Krishnawa/WLED_HW/README.md

# WLED_HW
a WLED based ESP12F Hardware
You can find more information about WLED here: https://github.com/Aircoookie/WLED

## Hardware photo
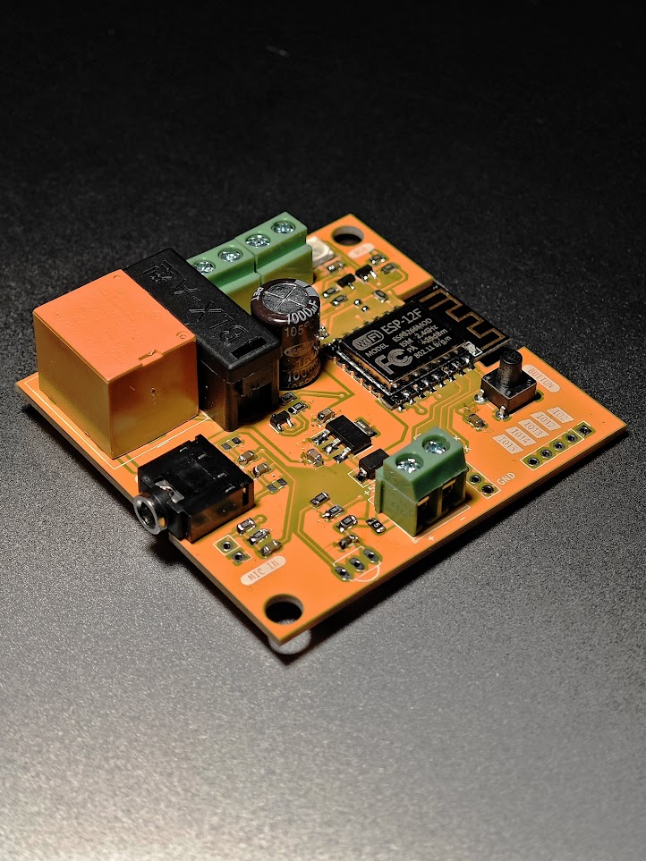
[picture p1: WLED_PROTOTYPE_V0.1/PHOTOS/Board.jpeg]
WLED Hardware
