Krishnawa/WLED_HW/WLED_PROTOTYPE_V0.1/PHOTOS/WLED_V0.1_panelized.png

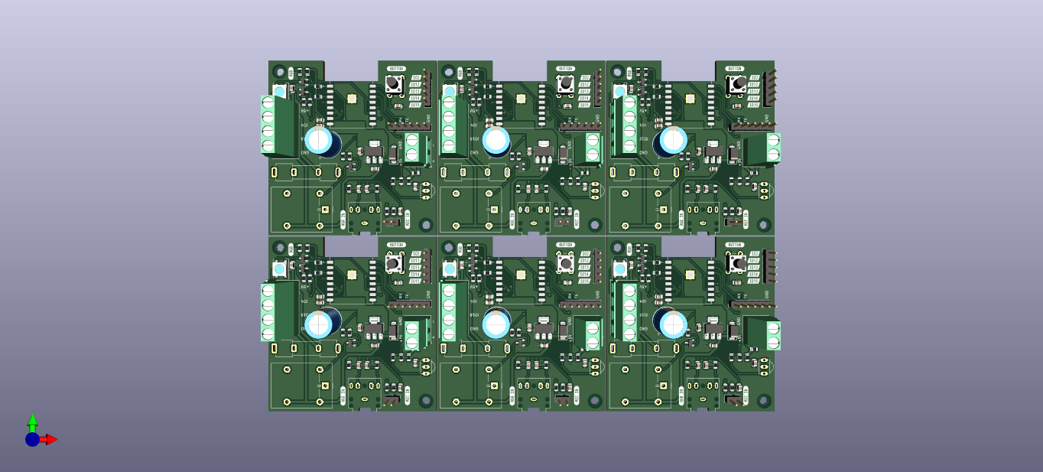
WLED_PROTOTYPE_V0.1/PHOTOS/WLED_V0.1_panelized.png
