Krishnawa/WLED_HW/WLED_PROTOTYPE_V0.1/BOM/WLED_V0.1.xlsx

# | Reference | Qty | Value | DESCRIPTION | SUNROM SKU | UNIT PRICE | PRICE | LINK
1 | C1, C2, C4 | 3 | 10u | 10uF 106 0805 (2012 metric) 50V X7R MLCC SMD | 3913 | 1.5 | 4.5 | https://www.sunrom.com/p/10uf-106-0805-2012-metric-50v-x7r-mlcc-smd
2 | C3, C6, C7, C8, C9, C10 | 6 | 100n | 100nF 104 0805 (2012 metric) 50V X7R MLCC | 3942 | 1.3 | 7.8 | https://www.sunrom.com/p/100nf-104-0805-2012-metric-50v-x7r-mlcc
3 | C5 | 1 | 1000u | 1000uF 16V 10mm Samwha | 6984 | 9 | 9 | https://www.sunrom.com/p/1000uf-16v-10mm-samwha
4 | C11 | 1 | 4.7uF | 4.7uF 475 0603 (1608 metric) 50V X7R MLCC SMD | 6798 | 1.2 | 1.2 | https://www.sunrom.com/p/47uf-475-0603-1608-metric-50v-x7r-mlcc-smd
5 | D1 | 1 | SS16 | SS16 SMA Schottky Diode | 5920 | 1.45 | 1.45 | https://www.sunrom.com/m/5920
6 | D2 | 1 | WS2812B | WS2812B Smart RGB LED | 4366 | 23.6 | 23.6 | https://www.sunrom.com/p/smart-rgb-led
7 | F1 | 1 | Fuse | 0805 PPTC Bourns Part# MF-PSMF050X-2 0.5A 6V 500MA | 4517 | 11.25 | 11.25 | https://www.sunrom.com/p/500ma-pptc-resettable-fuses
8 | F2 | 1 | Fuse | PCB Mount Fuse Holder for 5x20mm Fuses | 4940 | 11.8 | 11.8 | https://www.sunrom.com/p/pcb-mount-fuse-holder-for-5x20mm-fuses
11 | J3 | 2 | Screw_Terminal_01x04 | 2P 5mm 10A Screw Terminal Light | 3883 | 16.5 | 33 | https://www.sunrom.com/p/2p-5mm-10a-screw-terminal-light
12 | J4 | 1 | Screw_Terminal_01x02 | 2P 5mm 10A Screw Terminal Light | 3883 | 8.25 | 8.25 | https://www.sunrom.com/p/2p-5mm-10a-screw-terminal-light
14 | J6 | 1 | AudioJack2_Ground_Switch | Stereo Socket - PCB Mount – 3.5mm | 3986 | 10.03 | 10.03 | https://www.sunrom.com/p/stereo-socket
15 | K1 | 1 | G5LE-1 | Relay 5V - PCB Mount | 3871 | 28 | 28 | https://www.sunrom.com/p/relay-5v-pcb-mount
17 | Q1, Q2, Q3 | 3 | BSS138 | BSS138 SOT23 - MOSFET - N-Channel Hottech | 5592 | 4.75 | 14.25 | https://www.sunrom.com/m/5592
18 | R1, R3, R4, R7, R8, R9, R10, R11, R13,R5, R6 | 11 | 10K | 10K 1% 0805 | 4068 | 0.4 | 4.4 | https://www.sunrom.com/p/10k-1-0805-pack-of-100
19 | R2 | 1 | 10K | 10K 1% 0805 | 4068 |  | 0
21 | R12, R14 | 2 | 3.3K | 3K3 1% 0805 | 4276 | 0.4 | 0.8 | https://www.sunrom.com/p/3k3-1-0805
22 | R15 | 1 | 100 | 100R 1% 0805 | 4505 | 0.4 | 0.4 | https://www.sunrom.com/p/100r-1-0805
23 | SW2 | 1 | SW_SPST | Tactile Switch 6x6x8mm | 5828 | 3.54 | 3.54 | https://www.sunrom.com/p/tactile-switch-6x6x8mm
24 | U1 | 1 | ESP-12S | WiFi Module - ESP8266 - ESP-12F 4MB | 6182 | 255 | 255 | https://www.sunrom.com/p/wifi-module---esp8266---esp-12f-4mb
25 | U2 | 1 | NCP1117-3.3_SOT223 | 1117-3V3 3.3V 1A SOT223 Low Drop Linear Voltage Regulator | 4004 | 9.25 | 9.25 | https://www.sunrom.com/p/1117-3v3-33v-1a-sot223-low-drop-linear-voltage-regulator
26 | U3 | 1 | TSOP1838 | TSOP1838:TSOP18XX | 4471 | 16 | 16 | https://www.sunrom.com/m/4471
 |  |  |  |  |  | TOTAL PRICE | 453.52 | RS
