Krishnawa/WLED_HW/WLED_PROTOTYPE_V0.1/Excel/All Sspec.xlsx

Sheet: Product spec
Product specifications
Power supply | 5V
 | TYPE C USB
Current consumption | Without LED Max 550mA
 | https://wled-calculator.github.io/
Connnectivity | Wi-Fi
Audio | Mic
 | Aux
Indicator | On board LED
Supported LEDs

Sheet: Controller Spec
Column1 | Column2
Module Model | ESP-12S
Package | SMD16
Size | 24*16*3(±0.2)mm
Certification | FCC/CE
SPI Flash | Default 32Mbit
Interface | UART/GPIO/ADC/PWM
IO Port | 9
UART Baud rate | Support 300 ~ 4608000 bps ，Default 115200 bps
Frequency Range | 2412 ~ 2484MHz
Antenna | PCB Antenna
Transmit Power | 802.11b: 16±2 dBm (@11Mbps) 802.11g: 14±2 dBm (@54Mbps) 802.11n: 13±2 dBm (@HT20, MCS7)
Receiving Sensitivity | CCK, 1 Mbps : -90dBm CCK, 11 Mbps: -85dBm 6 Mbps (1/2 BPSK): -88dBm 54 Mbps (3/4 64-QAM): -70dBm HT20, MCS7 (65 Mbps, 72.2 Mbps): -67dBm
Power (Typical Values) | Continuous Transmission=>Average：~71mA，Peak： 500mA Modem Sleep: ~20mA Light Sleep: ~2mA Deep Sleep: ~0.02mA
Security | WEP/WPA-PSK/WPA2-PSK
Power Supply | Voltage 3.0V ~ 3.6V，Typical 3.3V，Current >500mA
Operating Temperature | -20 ℃ ~ 85 ℃
Storage Environment | -40 ℃ ~ 85 ℃ , < 90%RH

Sheet: Pinout
No. | Pin Name | Functional Description
1 | RST | Reset Pin, Active Low
2 | ADC | AD conversion, Input voltage range 0~1V, the value range is 0~1024.
3 | EN | Chip Enabled Pin, Active High
4 | IO16 | Connect with RST pin to wake up Deep Sleep
5 | IO14 | GPIO14; HSPI_CLK
6 | IO12 | GPIO12; HSPI_MISO
7 | IO13 | GPIO13; HSPI_MOSI; UART0_CTS
8 | VCC | Module power supply pin, Voltage 3.0V ~ 3.6V
9 | GND | GND
10 | IO15 | GPIO15; MTDO; HSPICS; UART0_RTS
11 | IO2 | GPIO2; UART1_TXD
12 | IO0 | GPIO0;HSPI_MISO;I2SI_DATA
13 | IO4 | GPIO4
14 | IO5 | GPIO5;IR_R
15 | RXD | UART0_RXD; GPIO3
16 | TXD | UART0_TXD; GPIO1
