Krishnawa/WLED_HW/WLED_PROTOTYPE_V0.1/ASSEMBLY/plots/WLED_V0.1__Assembly.pdf

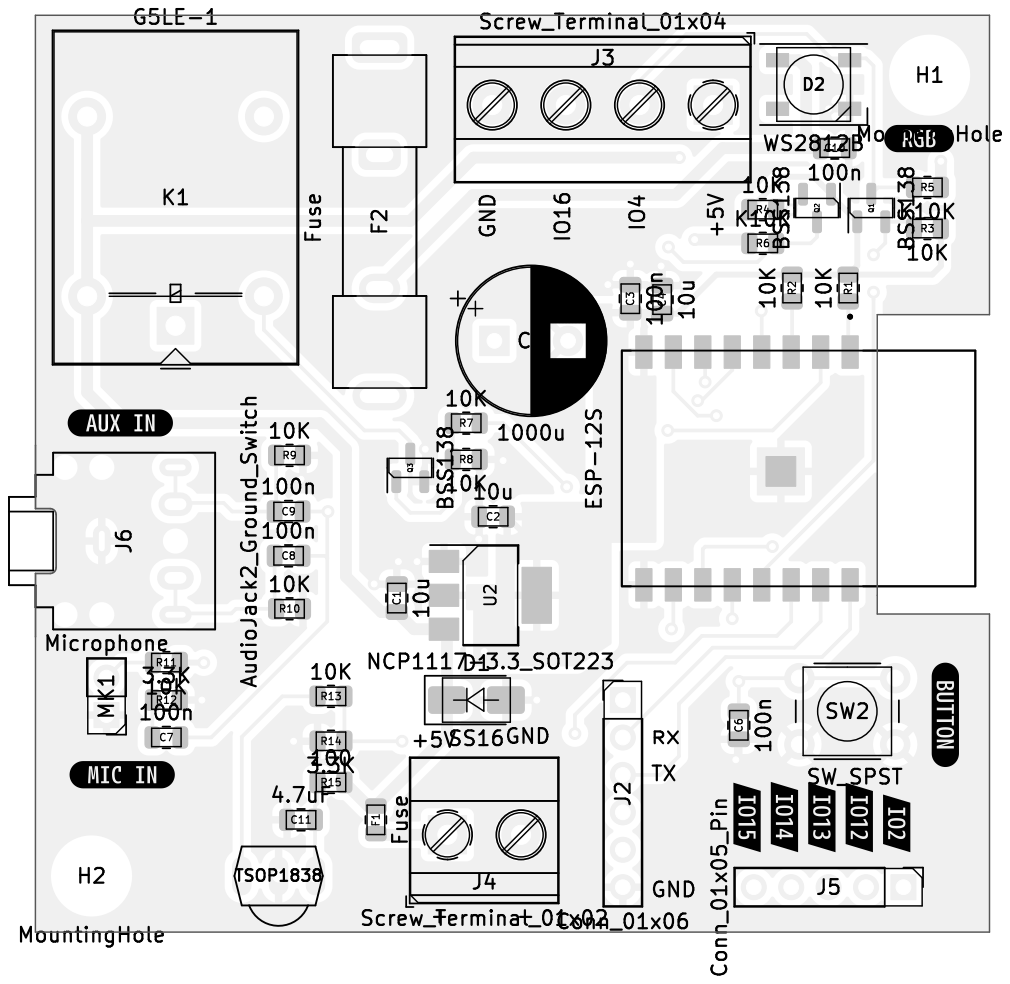
[picture p4: page 1]

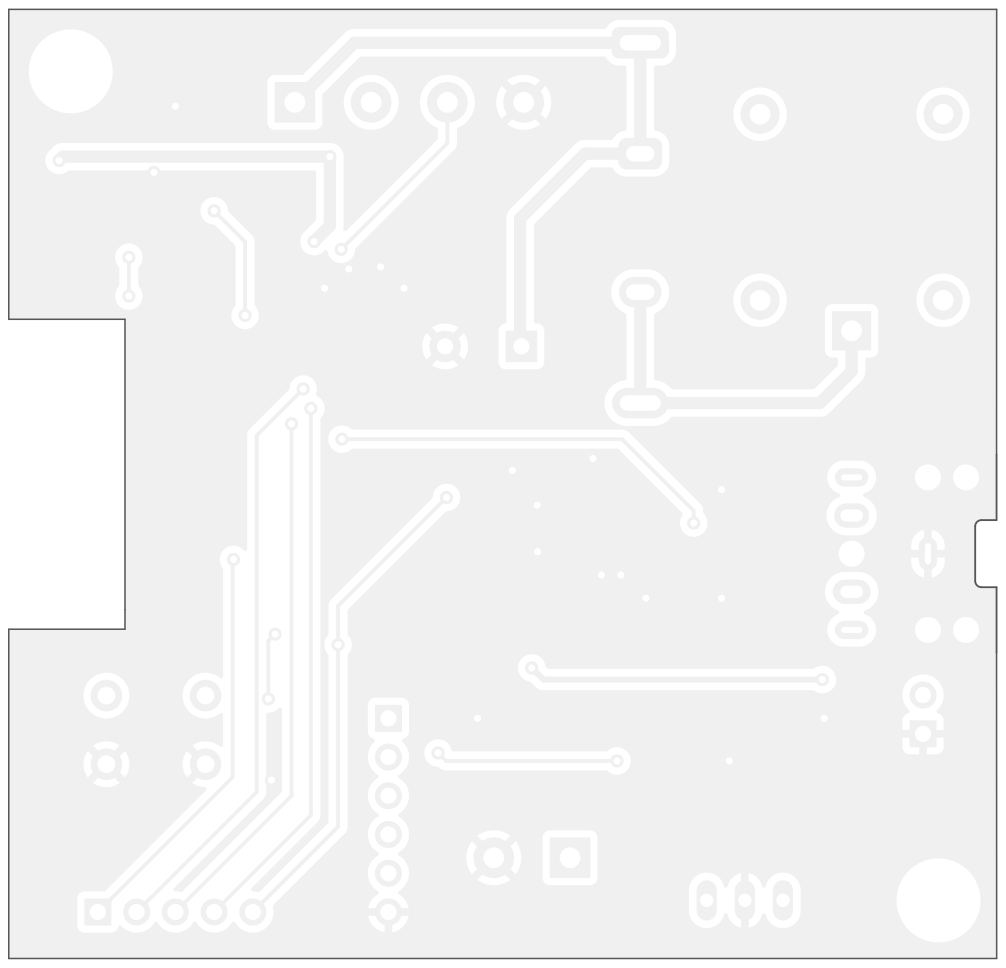
[picture p5: page 2]
D Date: KiCad; kicad; 7.0.8-7.0.8~ubuntu20.04.1 Size: A4; Rev:

Id: 1/1 Title: File: WLED_V0.1.kicad_pcb Sheet:
