Krishnawa/WLED_HW/WLED_PROTOTYPE_V0.1/WLED_V0.1/WLED_V0.1.pdf

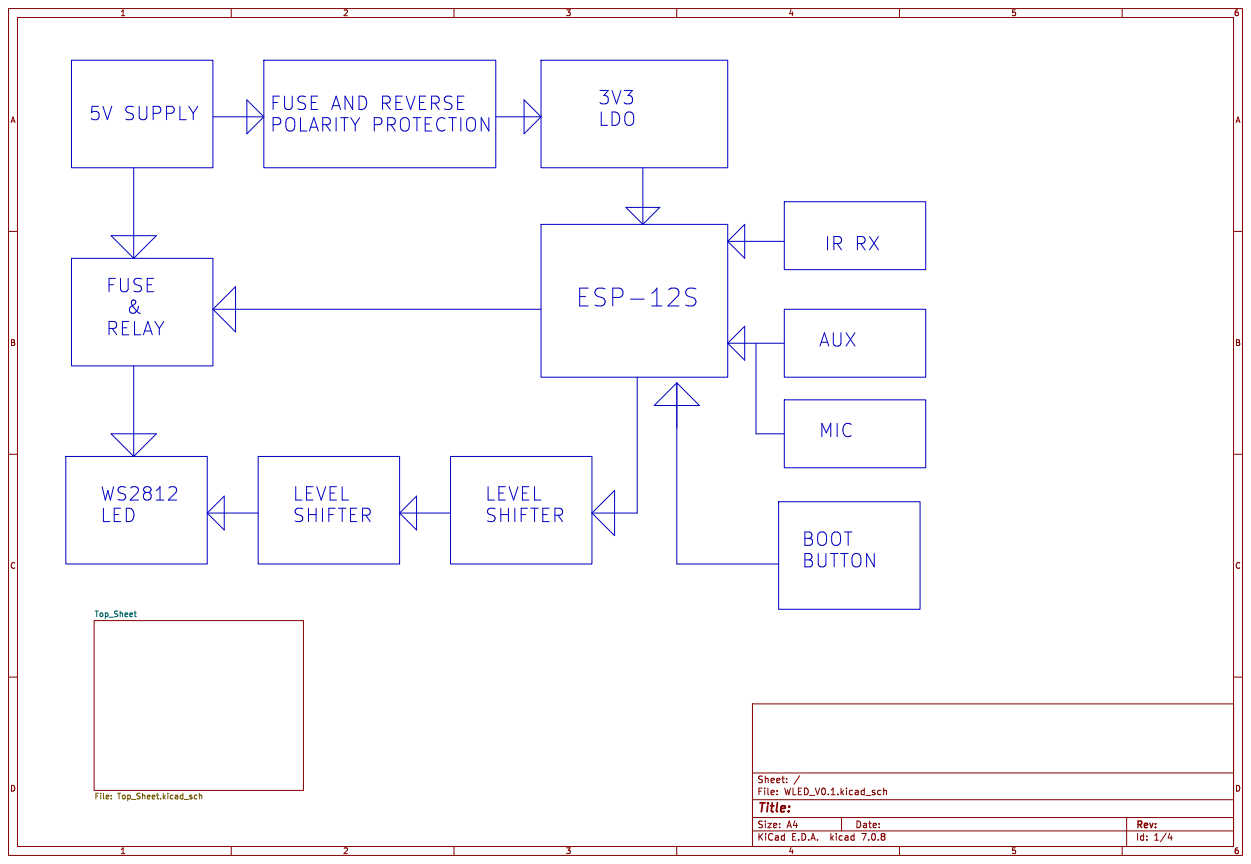
[picture p6: page 1]

Id: 1/4 Title: File: WLED_V0.1.kicad_sch Sheet: / Top_Sheet File: Top_Sheet.kicad_sch
