Krishnawa/WLED_HW/WLED_PROTOTYPE_V0.1/SCHEMATIC/SCH.pdf

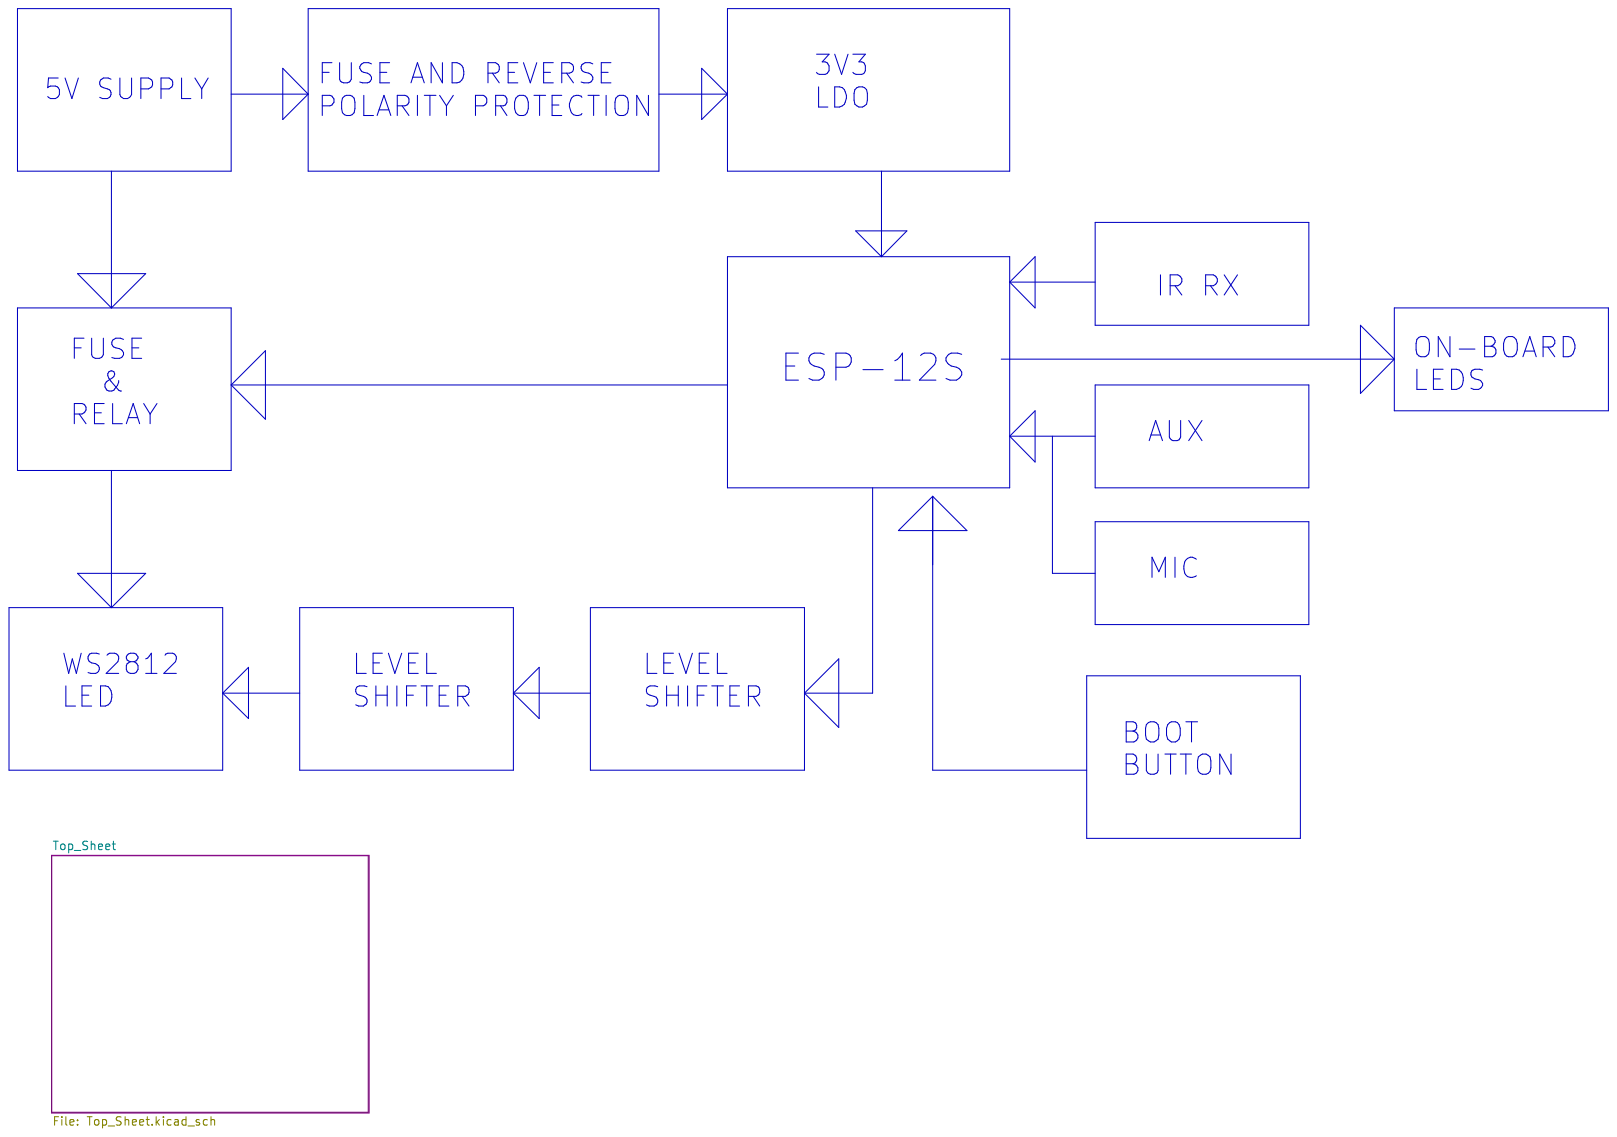
[picture p7: page 1]

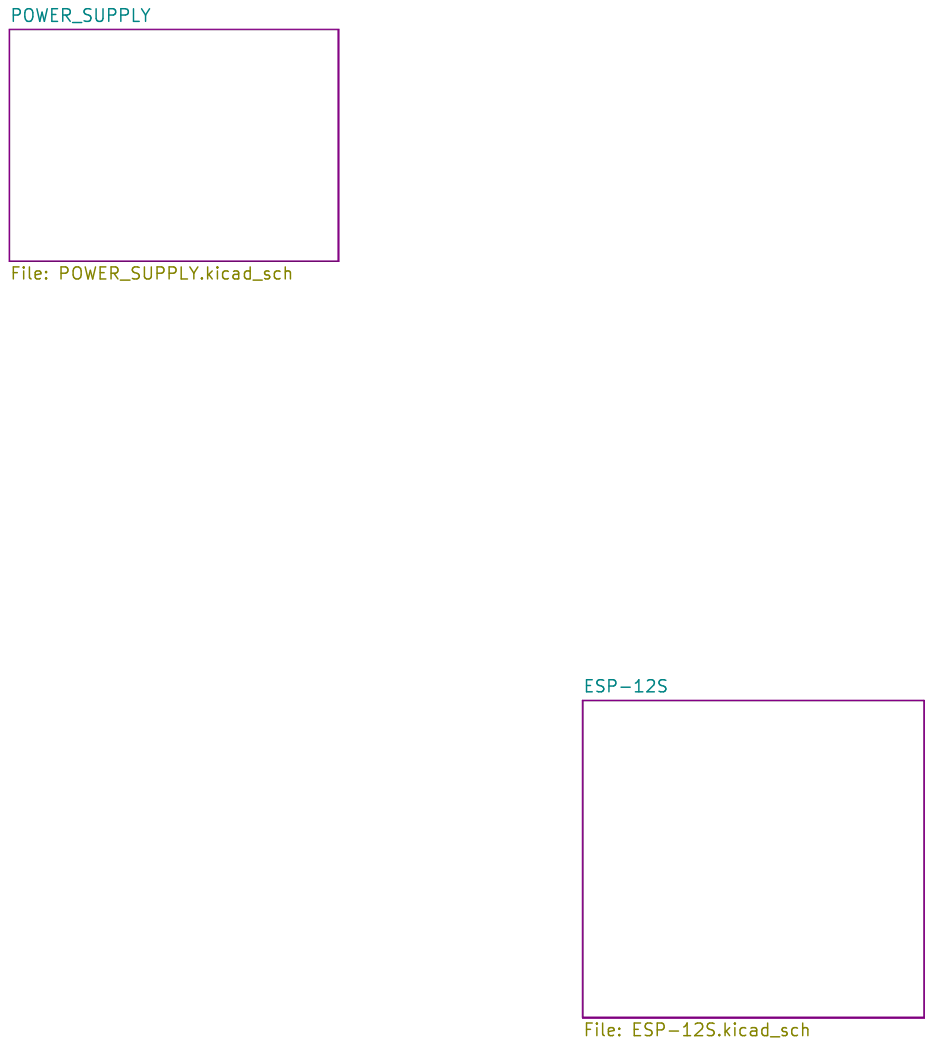
[picture p8: page 2]

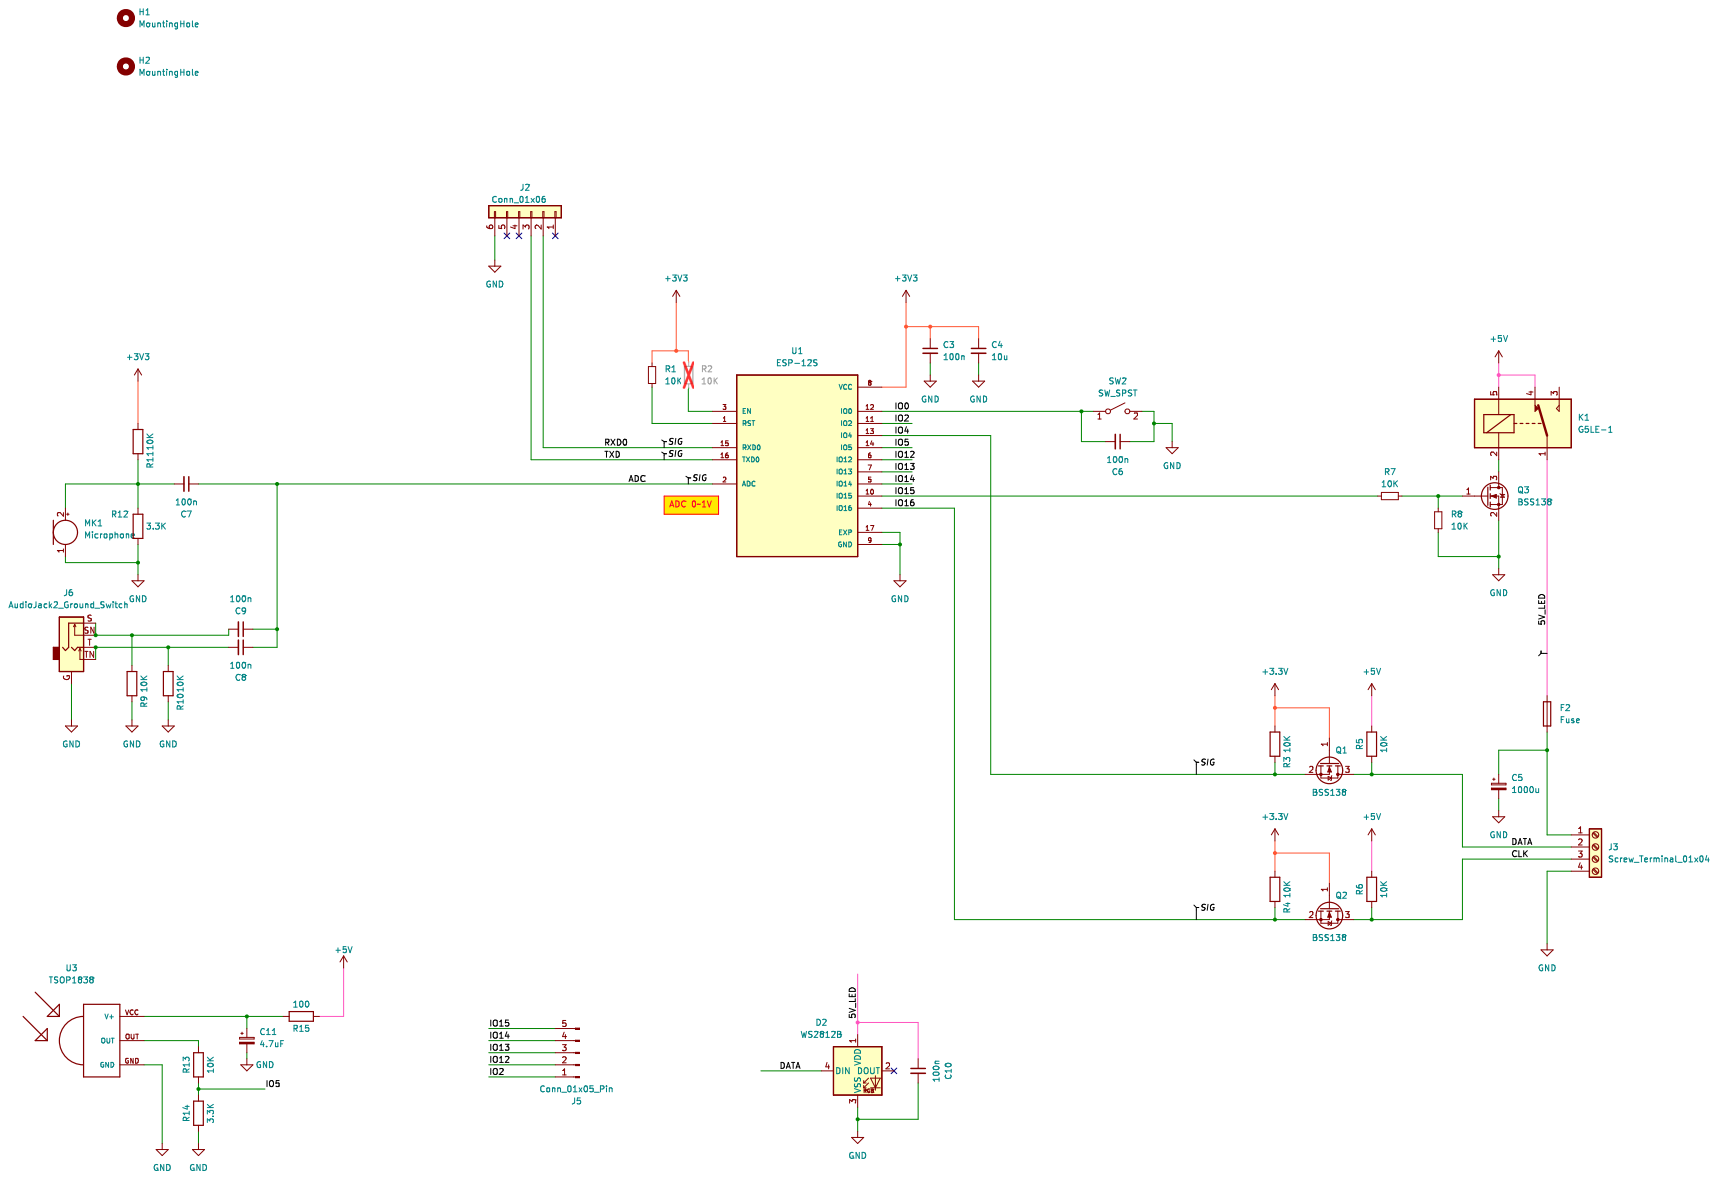
[picture p9: page 3]

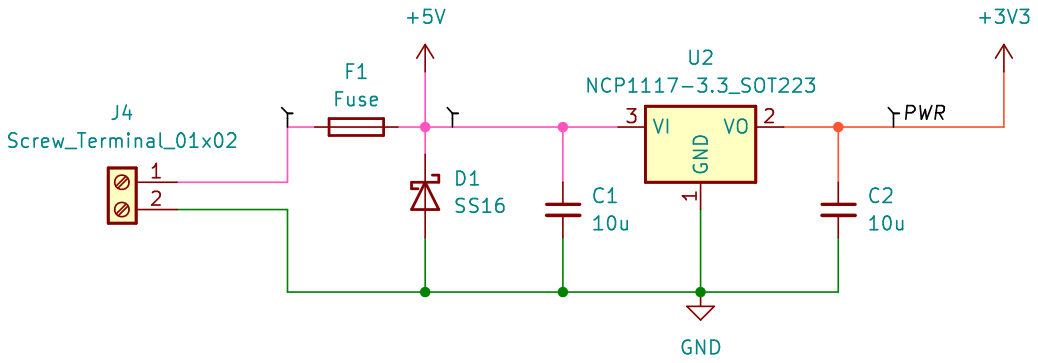
[picture p10: page 4]
