Krishnawa/WLED_HW/(list of files, drawings)

Other design files:
WLED_PROTOTYPE_V0.1/WLED_V0.1/freerouting.dsn
WLED_PROTOTYPE_V0.1/WLED_V0.1/temp-freerouting.dsn
