Krishnawa/WLED_HW/WLED_PROTOTYPE_V0.1/WLED_V0.1/WLED_V0.1.kicad_pcb

## KiCad design WLED_PROTOTYPE_V0.1/WLED_V0.1/WLED_V0.1.kicad_pcb (2024-01-28)

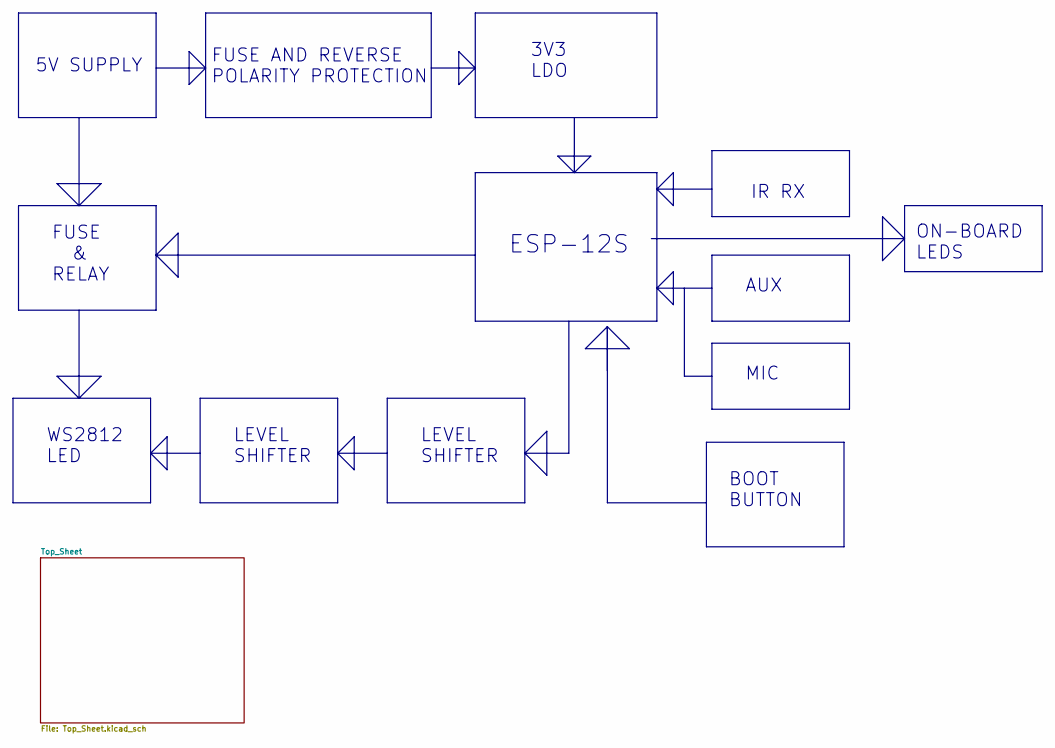
[picture p11: schematic WLED_V0.1.kicad_sch]

Notes on the sheet:
FUSE AND REVERSE POLARITY PROTECTION
BOOT BUTTON
WS2812 LED
LEVEL SHIFTER
ESP-12S
3V3 LDO
IR RX
FUSE & RELAY
AUX
MIC
5V SUPPLY
ON-BOARD LEDS

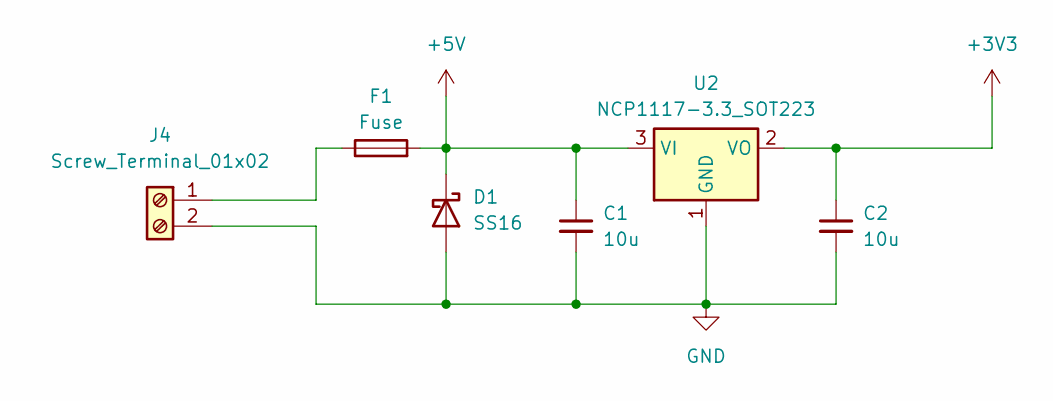
[picture p12: schematic POWER_SUPPLY.kicad_sch]

Parts:
C1, C2: 10u; C_0805_2012Metric
D1: SS16; D_SMA
F1: Fuse; Fuse_0805_2012Metric
J4: Screw_Terminal_01x02; TerminalBlock_Phoenix_MKDS-1,5-2_1x02_P5.00mm_Horizontal
U2: NCP1117-3.3_SOT223; SOT-223-3_TabPin2

Connections:
+5V: C1.1, D1.1 (K), F1.2, U2.3 (VI); also elsewhere on the board
GND: C1.2, C2.2, D1.2 (A), J4.2, U2.1 (GND); also elsewhere on the board
unnamed: F1.1, J4.1

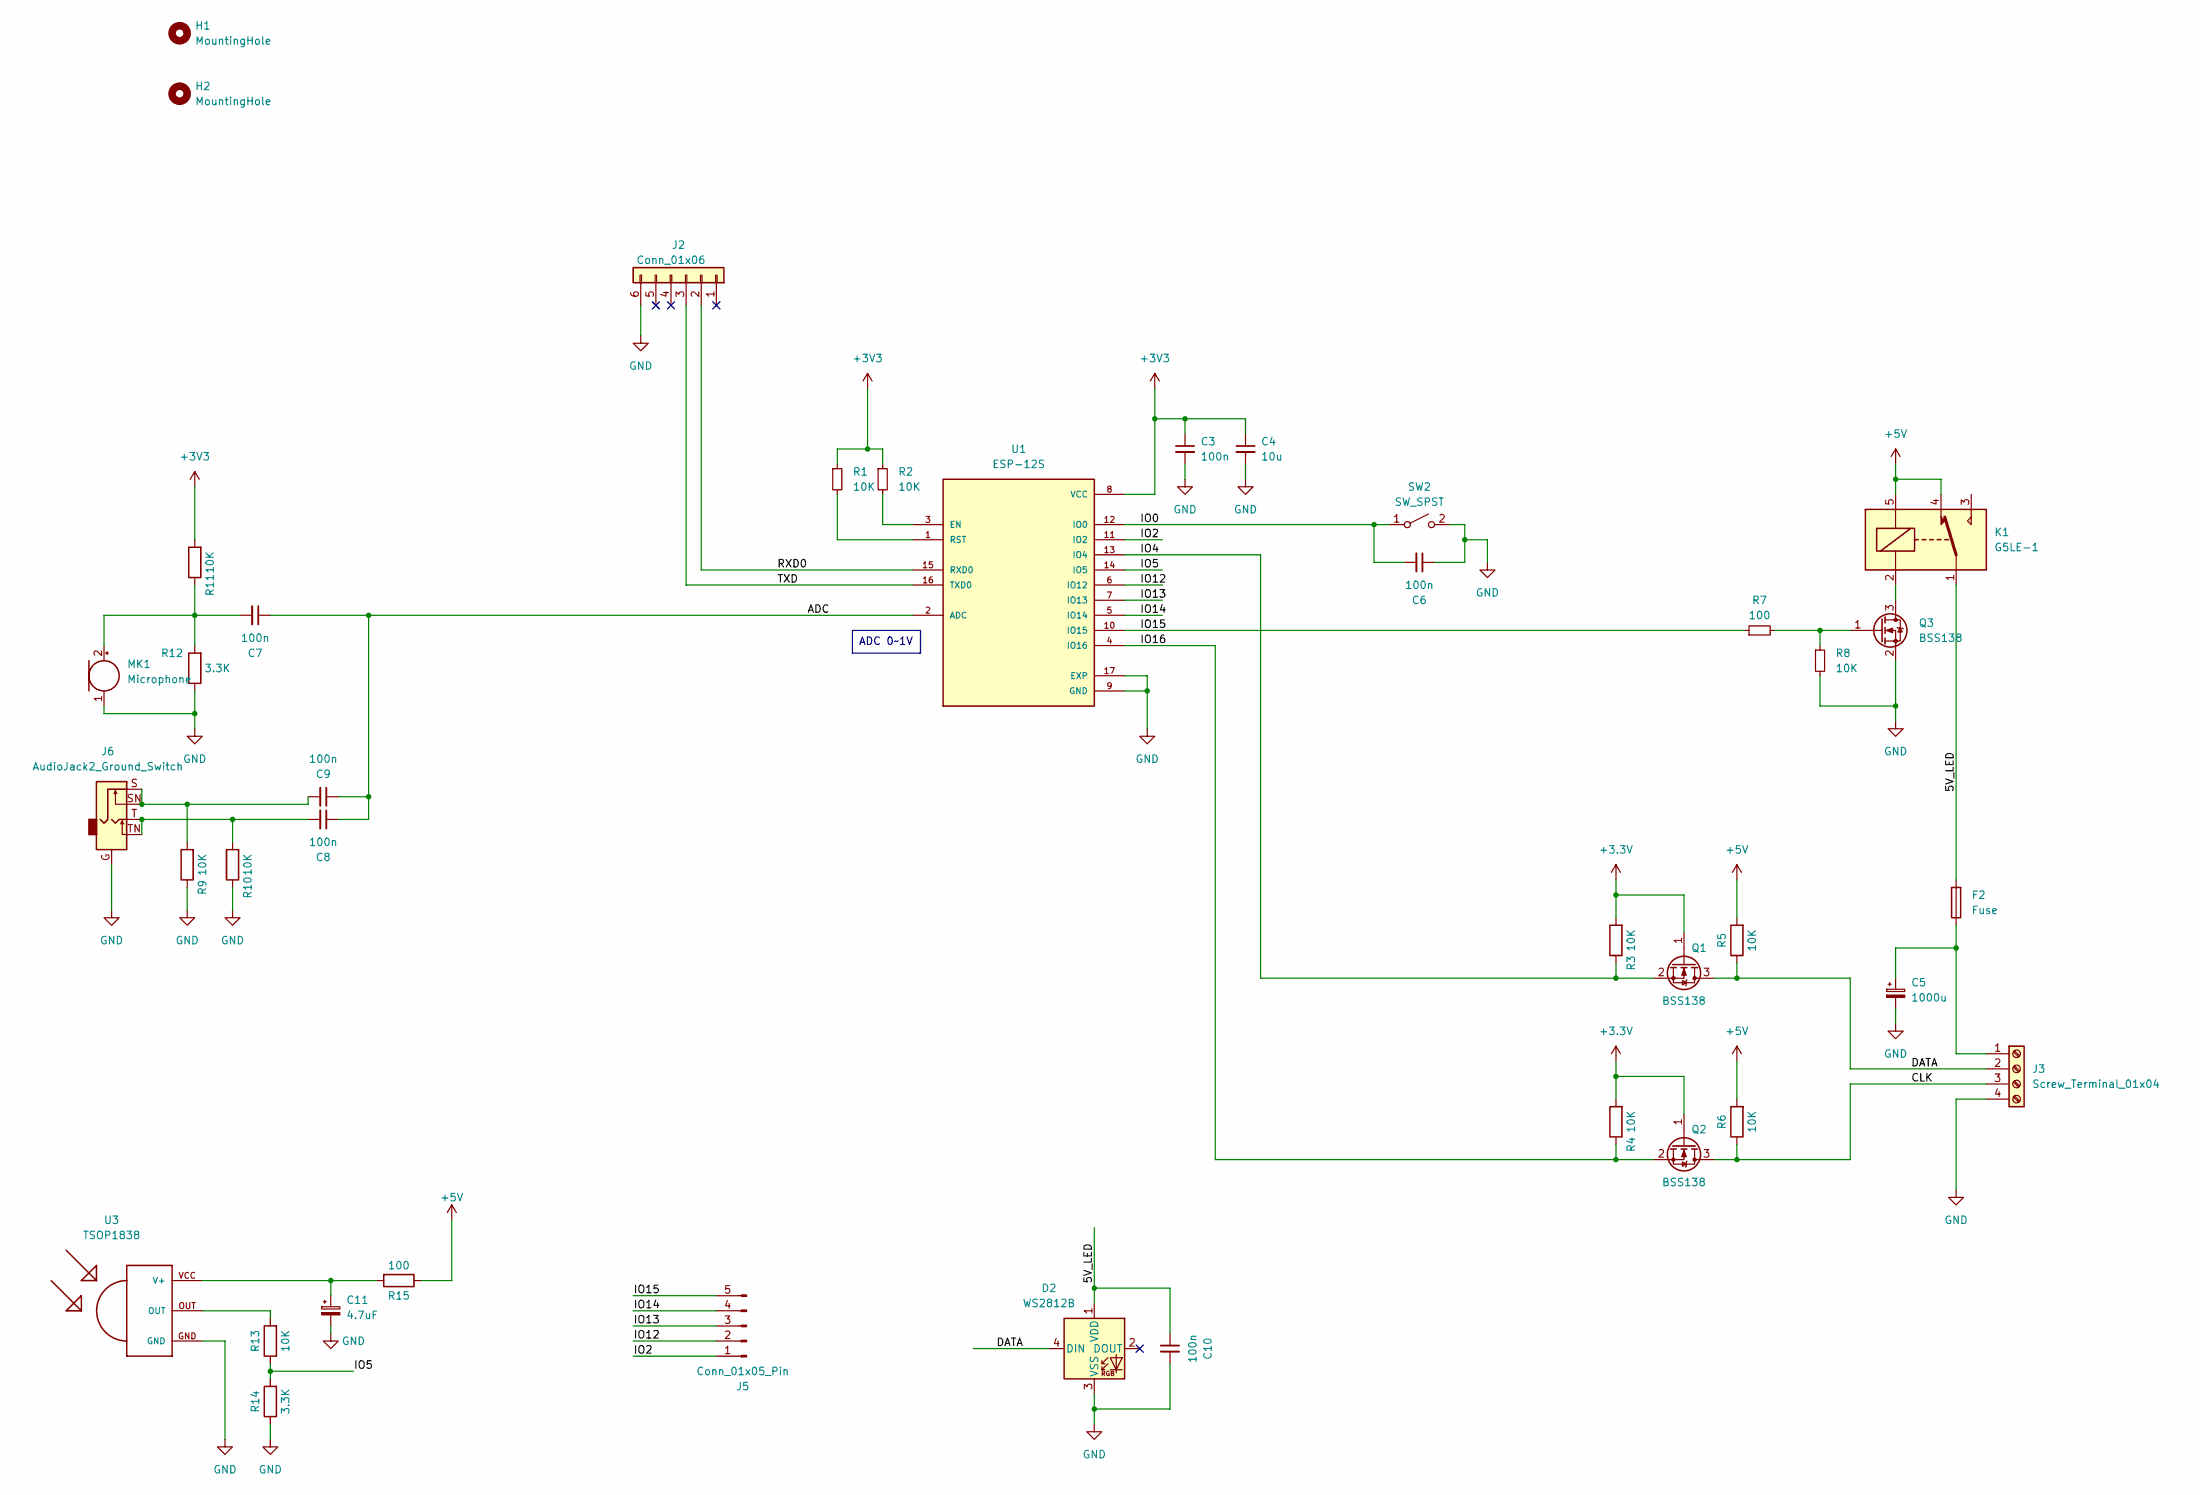
[picture p13: schematic ESP-12S.kicad_sch]

Parts:
C3, C6, C7, C8, C9, C10: 100n; C_0805_2012Metric
C4: 10u; C_0805_2012Metric
C5: 1000u; CP_Radial_D10.0mm_P5.00mm
C11: 4.7uF; C_0805_2012Metric
D2: WS2812B; LED_WS2812B_PLCC4_5.0x5.0mm_P3.2mm
F2: Fuse; Fuseholder_Clip-5x20mm_Keystone_3512P_Inline_P23.62x7.27mm_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
H1, H2: MountingHole; MountingHole_3mm
J2: Conn_01x06; PinHeader_1x06_P2.54mm_Vertical
J3: Screw_Terminal_01x04; TerminalBlock_Phoenix_MKDS-1,5-4_1x04_P5.00mm_Horizontal
J5: Conn_01x05_Pin; PinHeader_1x05_P2.54mm_Vertical
J6: AudioJack2_Ground_Switch; Jack_3.5mm_CUI_SJ1-3525N_Horizontal
K1: G5LE-1; Relay_SPDT_Omron-G5LE-1
MK1: Microphone; PinHeader_1x02_P2.54mm_Vertical
Q1, Q2, Q3: BSS138; SOT-23
R1, R2, R3, R4, R5, R6, R8, R9, R10, R11, R13: 10K; R_0805_2012Metric
R7, R15: 100; R_0805_2012Metric
R12, R14: 3.3K; R_0805_2012Metric
SW2: SW_SPST; SW_PUSH_6mm_H7.3mm
U1: ESP-12S; MODULE_ESP-12S; PARTREV V1.1
U3: TSOP1838; TSOP18XX

Connections:
+5V: K1.4, K1.5, R5.2, R6.2, R15.1; also elsewhere on the board
/Top_Sheet/ESP-12S/5V_LED: C10.1, D2.1 (VDD), F2.2, K1.1
/Top_Sheet/ESP-12S/ADC: C7.1, C8.1, C9.1, U1.2 (ADC)
/Top_Sheet/ESP-12S/CLK: J3.3, Q2.3 (D), R6.1
/Top_Sheet/ESP-12S/DATA: D2.4 (DIN), J3.2, Q1.3 (D), R5.1
/Top_Sheet/ESP-12S/IO0: C6.2, SW2.1 (A), U1.12 (IO0)
/Top_Sheet/ESP-12S/IO2: J5.1, U1.11 (IO2)
/Top_Sheet/ESP-12S/IO4: Q1.2 (S), R3.1, U1.13 (IO4)
/Top_Sheet/ESP-12S/IO5: R13.1, R14.2, U1.14 (IO5)
/Top_Sheet/ESP-12S/IO12: J5.2, U1.6 (IO12)
/Top_Sheet/ESP-12S/IO13: J5.3, U1.7 (IO13)
/Top_Sheet/ESP-12S/IO14: J5.4, U1.5 (IO14)
/Top_Sheet/ESP-12S/IO15: J5.5, R7.1, U1.10 (IO15)
/Top_Sheet/ESP-12S/IO16: Q2.2 (S), R4.1, U1.4 (IO16)
/Top_Sheet/ESP-12S/RXD0: J2.2, U1.15 (RXD0)
/Top_Sheet/ESP-12S/TXD: J2.3, U1.16 (TXD0)
GND: C3.2, C4.2, C5.2, C6.1, C10.2, C11.2, D2.3 (VSS), J2.6, J3.4, J6.G, MK1.1 (-), Q3.2 (S), R8.2, R9.1, R10.1, R12.1, R14.1, SW2.2 (B), U1.9 (GND), U1.17 (EXP), U3.GND; also elsewhere on the board
unnamed: C8.2, J6.T, J6.TN, R10.2
unnamed: C9.2, J6.S, J6.SN, R9.2
unnamed: C5.1, F2.1, J3.1
unnamed: C7.2, MK1.2 (+), R11.1, R12.2
unnamed: K1.2, Q3.3 (D)
unnamed: Q3.1 (G), R7.2, R8.1
unnamed: R13.2, U3.OUT
unnamed: R2.2, U1.3 (EN)
unnamed: R1.2, U1.1 (RST)
unnamed: C11.1, R15.2, U3.VCC (V+)

Notes on the sheet:
ADC 0~1V

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
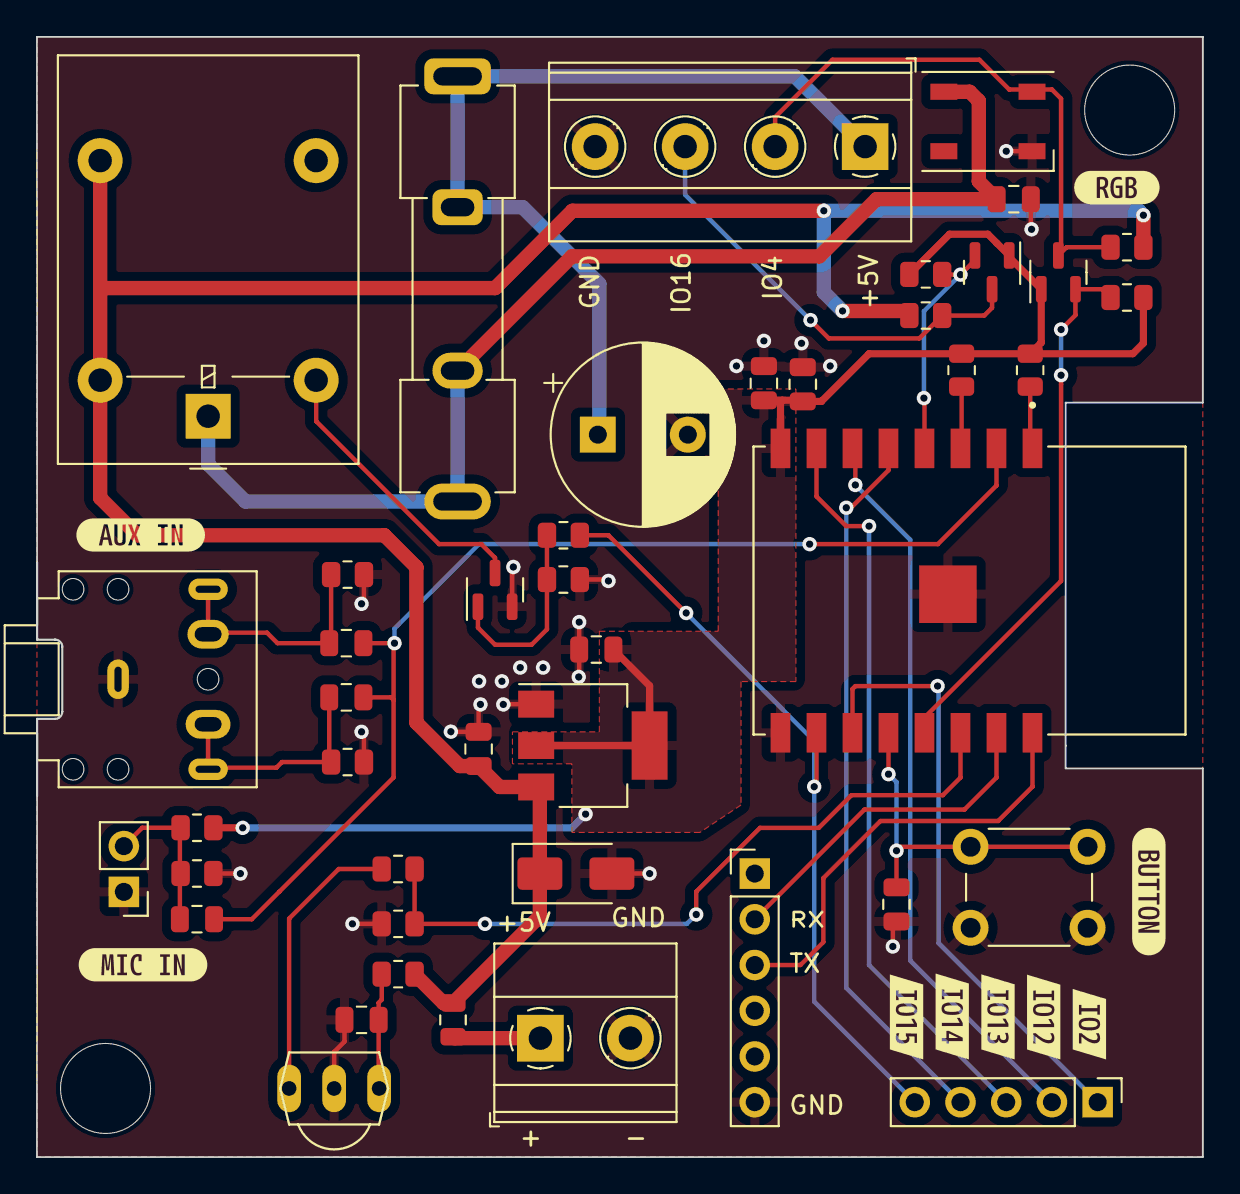
[picture p14: board WLED_V0.1.kicad_pcb from above]

Board: 2 copper layers, 64.8 x 62.2 mm, 55 parts (0 on the bottom side), 29 nets.

Other parts of the board:
kibuzzard-6541D5B9: G***; kibuzzard-6541D5B9
kibuzzard-6541D5D1: G***; kibuzzard-6541D5D1
kibuzzard-6541D5EF: G***; kibuzzard-6541D5EF
kibuzzard-6541D591: G***; kibuzzard-6541D591
kibuzzard-6541D612: G***; kibuzzard-6541D612
kibuzzard-6541E98B: G***; kibuzzard-6541E98B
kibuzzard-6541E326: G***; kibuzzard-6541E326
kibuzzard-6541E704: G***; kibuzzard-6541E704
kibuzzard-6541E997: G***; kibuzzard-6541E997
