Krishnawa/WLED_HW/WLED_PROTOTYPE_V0.1/WLED_V0.1/Production/ordering_instructions.txt

Ordering Instructions:
Panel dimensions: 130.05 x 187.69 mm.
Solder Mask: Red (Default)
Silkscreen: White (Default)
Layers: 2 (Default)
Finish: HASL Lead-free (Default)
Thickness: 1.6mm (Default)
Copper weight: 1oz (Default)
Minimum track width: 0.25mm (9.84mil)
Minimum via drill: 0.40mm (15.75mil)
